catphish/ev-charge-controller/README

Charge Controller
=================

This controller has connectivity for CAN and EVSE as well as 4 x 12V digital inputs and 4 x low side switches.
