catphish/ev-charge-controller/hardware/charge-controller.pdf

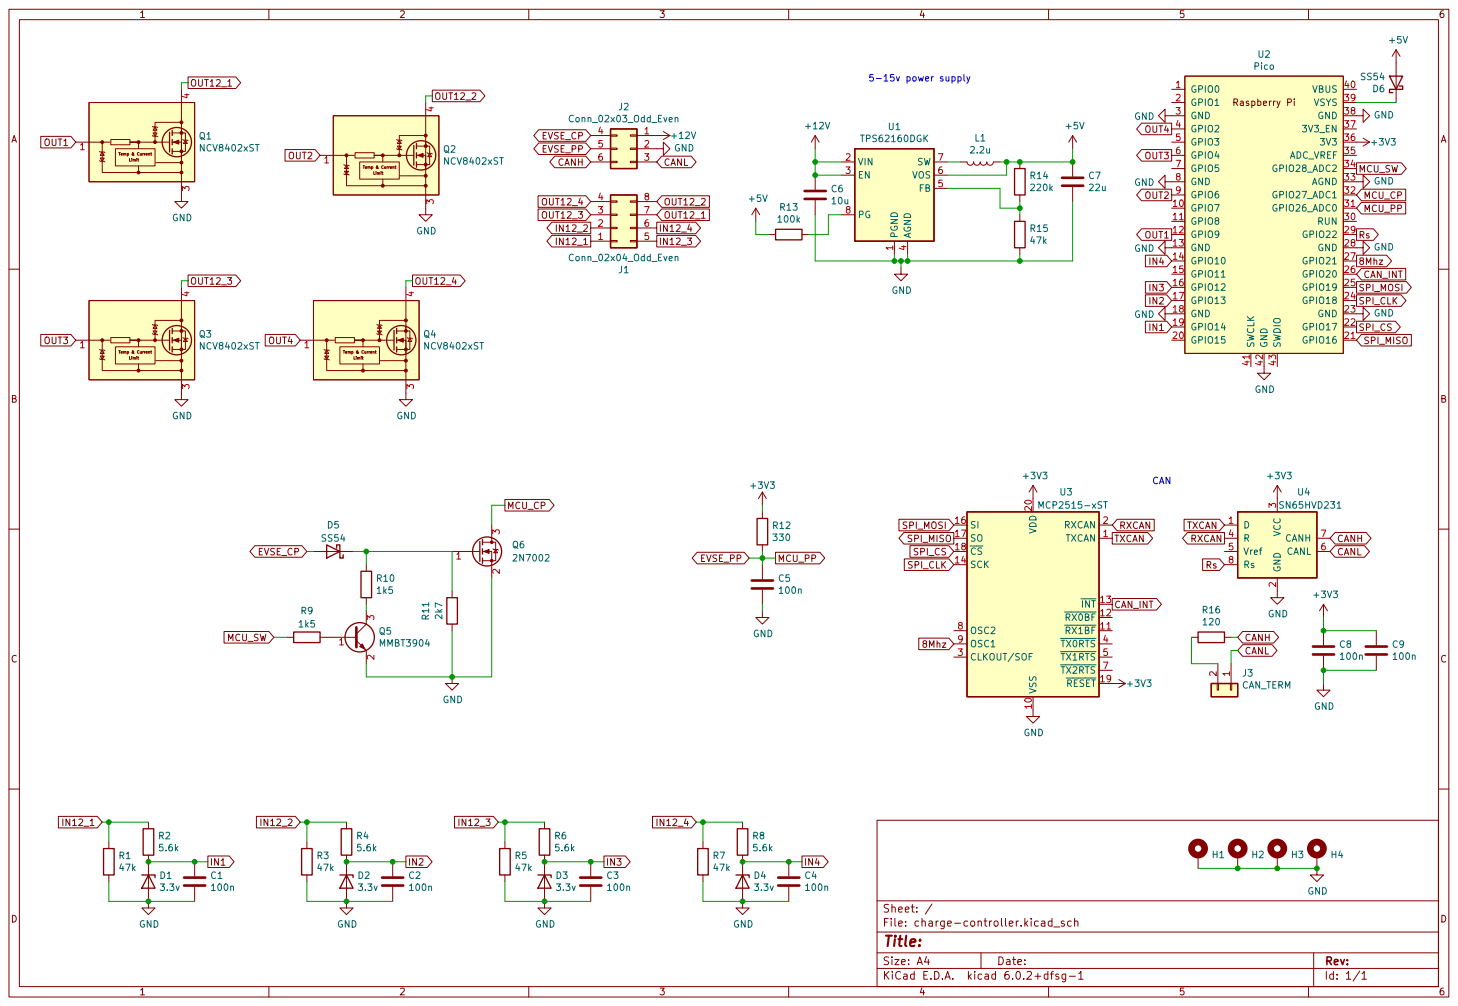
[picture p1: page 1]

4 FB 5 VOS 6 SW 7 PG 8 U1 TPS62160DGK

File: charge-controller.kicad_sch Sheet: /
Id: 1/1 Title:
