catphish/ev-charge-controller/hardware/charge-controller.kicad_pcb

## KiCad design hardware/charge-controller.kicad_pcb (2022-09-21)

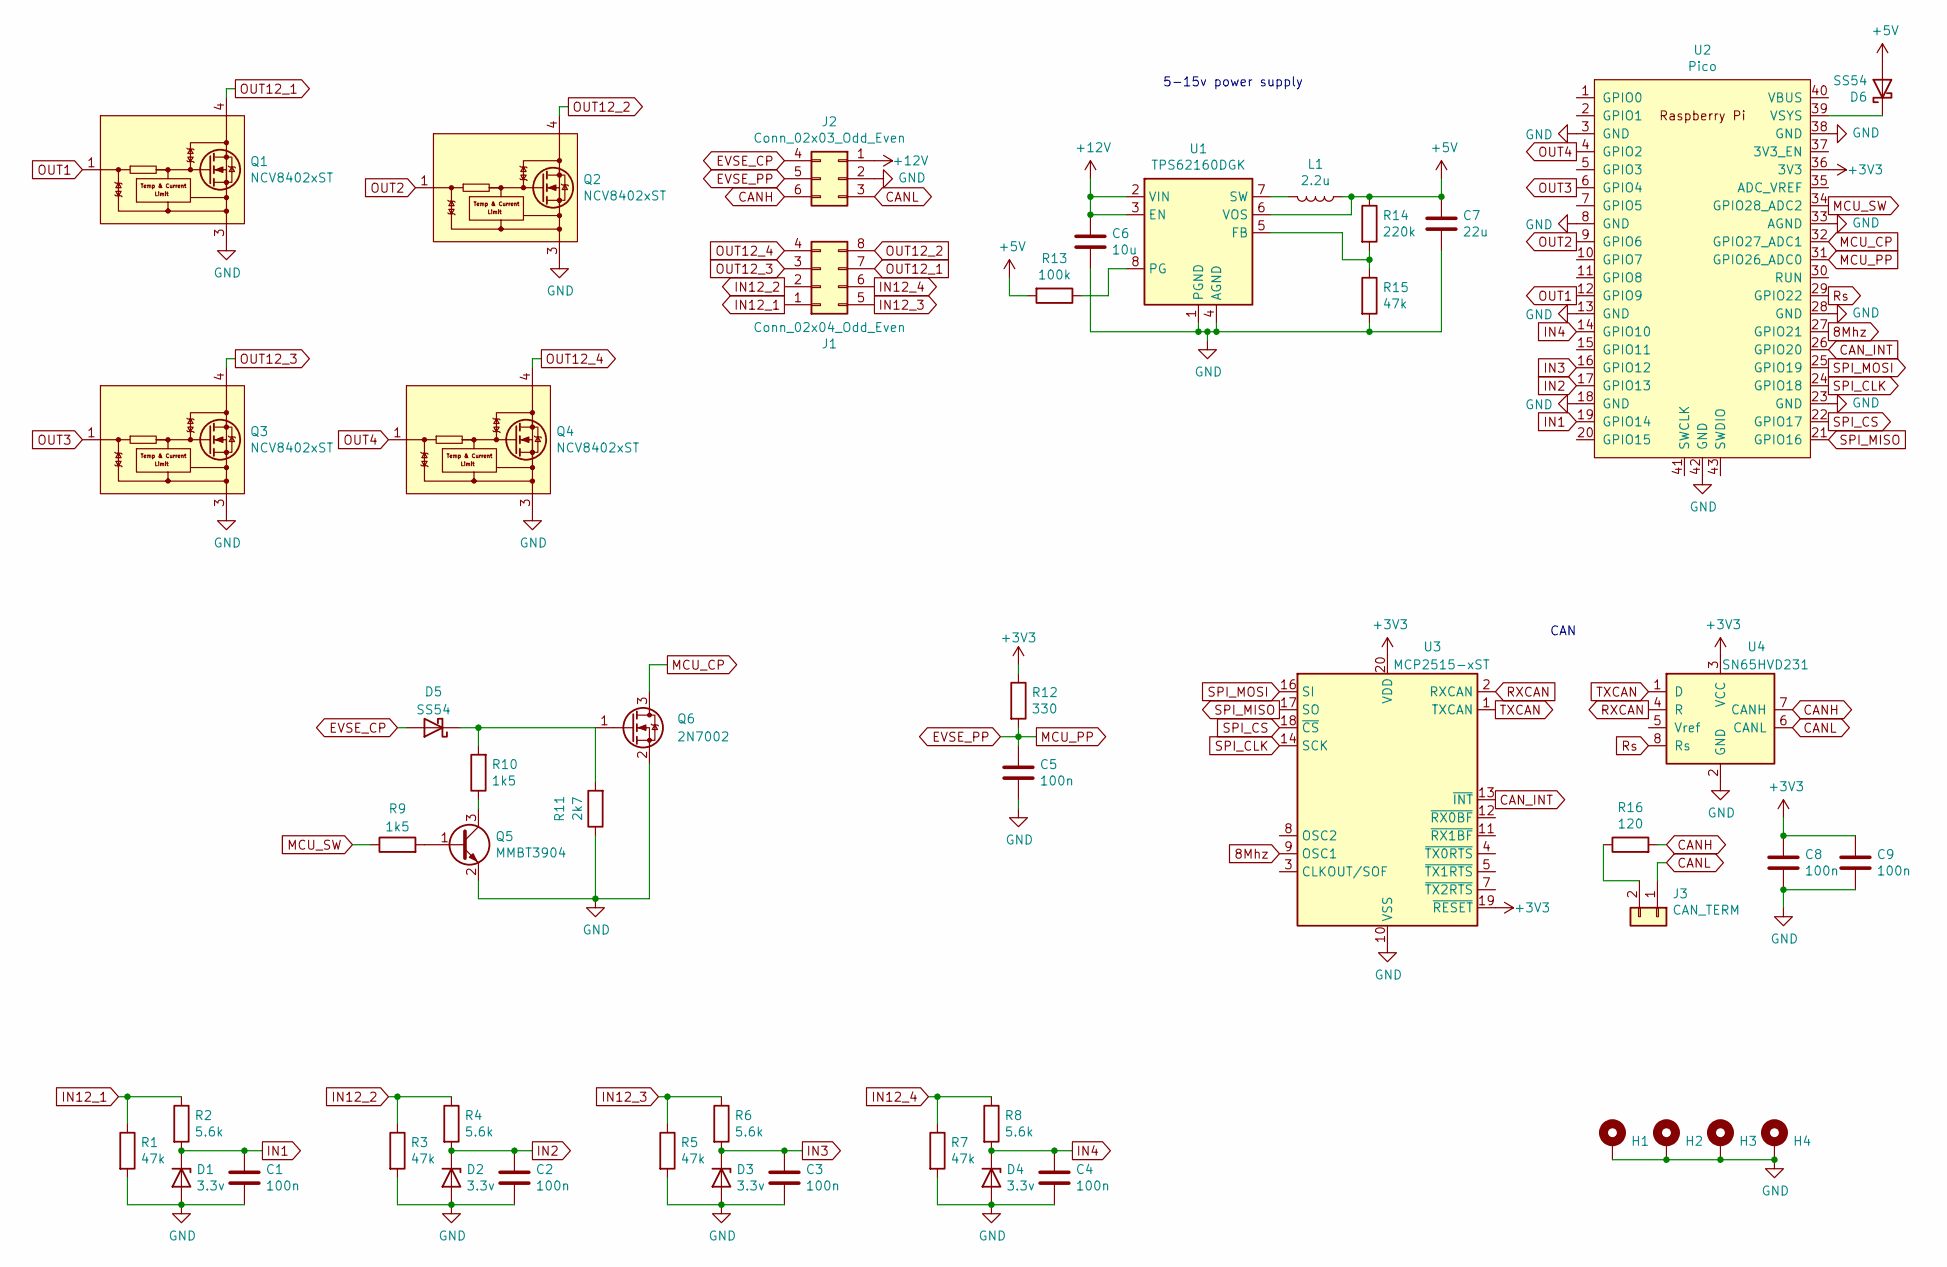
[picture p2: schematic charge-controller.kicad_sch]

Parts:
C1, C2, C3, C4, C5, C8, C9: 100n; C_0603_1608Metric; LCSC C14663
C6: 10u; C_1210_3225Metric; LCSC C77102
C7: 22u; C_1206_3216Metric; LCSC C5672
D1, D2, D3, D4: 3.3v; D_MiniMELF; LCSC C8056
D5, D6: SS54; D_SMA; LCSC C22452
H1, H2, H3, H4: MountingHole; MountingHole_3.2mm_M3_Pad
J1: Conn_02x04_Odd_Even; Molex_Micro-Fit_3.0_43045-0800_2x04_P3.00mm_Horizontal
J2: Conn_02x03_Odd_Even; Molex_Micro-Fit_3.0_43045-0600_2x03_P3.00mm_Horizontal
J3: CAN_TERM; PinHeader_1x02_P2.54mm_Vertical
L1: 2.2u; L_Neosid_SMS-ME3015; LCSC C43389
Q1, Q2, Q3, Q4: NCV8402xST; SOT-223; LCSC C77755
Q5: MMBT3904; SOT-23; LCSC C20526
Q6: 2N7002; SOT-23; LCSC C8545
R1, R3, R5, R7, R15: 47k; R_0603_1608Metric; LCSC C25819
R2, R4, R6, R8: 5.6k; R_0603_1608Metric; LCSC C23189
R9, R10: 1k5; R_0603_1608Metric; LCSC C22843
R11: 2k7; R_0603_1608Metric; LCSC C13167
R12: 330; R_0603_1608Metric; LCSC C23138
R13: 100k; R_0603_1608Metric; LCSC C25803
R14: 220k; R_0603_1608Metric; LCSC C22961
R16: 120; R_1206_3216Metric; LCSC C17909
U1: TPS62160DGK; MSOP-8_3x3mm_P0.65mm; LCSC C60726
U2: Pico; RPi_Pico_SMD_TH
U3: MCP2515-xST; TSSOP-20_4.4x6.5mm_P0.65mm; LCSC C15193
U4: SN65HVD231; SOIC-8_3.9x4.9mm_P1.27mm; LCSC C129257

Connections:
8Mhz: U2.27 (GPIO21), U3.9 (OSC1)
+3V3: C8.1, C9.1, R12.1, U2.36 (3V3), U3.19 (~RESET), U3.20 (VDD), U4.3 (VCC)
+5V: C7.1, D6.2 (A), L1.1, R13.2, R14.1, U1.6 (VOS)
+12V: C6.1, J2.1, U1.2 (VIN), U1.3 (EN)
CANH: J2.6, R16.2, U4.7 (CANH)
CANL: J2.3, J3.1, U4.6 (CANL)
CAN_INT: U2.26 (GPIO20), U3.13 (~INT)
EVSE_CP: D5.2 (A), J2.4
EVSE_PP: C5.1, J2.5, R12.2, U2.31 (GPIO26_ADC0)
GND: C1.2, C2.2, C3.2, C4.2, C5.2, C6.2, C7.2, C8.2, C9.2, D1.2 (A), D2.2 (A), D3.2 (A), D4.2 (A), H1.1, H2.1, H3.1, H4.1, J2.2, Q1.3 (S), Q2.3 (S), Q3.3 (S), Q4.3 (S), Q5.2 (E), Q6.2 (S), R1.2, R3.2, R5.2, R7.2, R11.1, R15.2, U1.1 (PGND), U1.4 (AGND), U2.3 (GND), U2.8 (GND), U2.13 (GND), U2.18 (GND), U2.23 (GND), U2.28 (GND), U2.33 (AGND), U2.38 (GND), U2.42 (GND), U3.10 (VSS), U4.2 (GND)
IN1: C1.1, D1.1 (K), R2.2, U2.19 (GPIO14)
IN2: C2.1, D2.1 (K), R4.2, U2.17 (GPIO13)
IN3: C3.1, D3.1 (K), R6.2, U2.16 (GPIO12)
IN4: C4.1, D4.1 (K), R8.2, U2.14 (GPIO10)
IN12_1: J1.1, R1.1, R2.1
IN12_2: J1.2, R3.1, R4.1
IN12_3: J1.5, R5.1, R6.1
IN12_4: J1.6, R7.1, R8.1
MCU_CP: Q6.3 (D), U2.32 (GPIO27_ADC1)
MCU_SW: R9.1, U2.34 (GPIO28_ADC2)
unnamed: D5.1 (K), Q6.1 (G), R10.2, R11.2
unnamed: D6.1 (K), U2.39 (VSYS)
unnamed: J3.2, R16.1
unnamed: L1.2, U1.7 (SW)
unnamed: Q5.1 (B), R9.2
unnamed: Q5.3 (C), R10.1
unnamed: R13.1, U1.8 (PG)
unnamed: R14.2, R15.1, U1.5 (FB)
OUT1: Q1.1 (G), U2.12 (GPIO9)
OUT2: Q2.1 (G), U2.9 (GPIO6)
OUT3: Q3.1 (G), U2.6 (GPIO4)
OUT4: Q4.1 (G), U2.4 (GPIO2)
OUT12_1: J1.7, Q1.2 (D), Q1.4 (D)
OUT12_2: J1.8, Q2.2 (D), Q2.4 (D)
OUT12_3: J1.3, Q3.2 (D), Q3.4 (D)
OUT12_4: J1.4, Q4.2 (D), Q4.4 (D)
RXCAN: U3.2 (RXCAN), U4.4 (R)
Rs: U2.29 (GPIO22), U4.8 (Rs)
SPI_CLK: U2.24 (GPIO18), U3.14 (SCK)
SPI_CS: U2.22 (GPIO17), U3.18 (~CS)
SPI_MISO: U2.21 (GPIO16), U3.17 (SO)
SPI_MOSI: U2.25 (GPIO19), U3.16 (SI)
TXCAN: U3.1 (TXCAN), U4.1 (D)

Notes on the sheet:
CAN
5-15v power supply

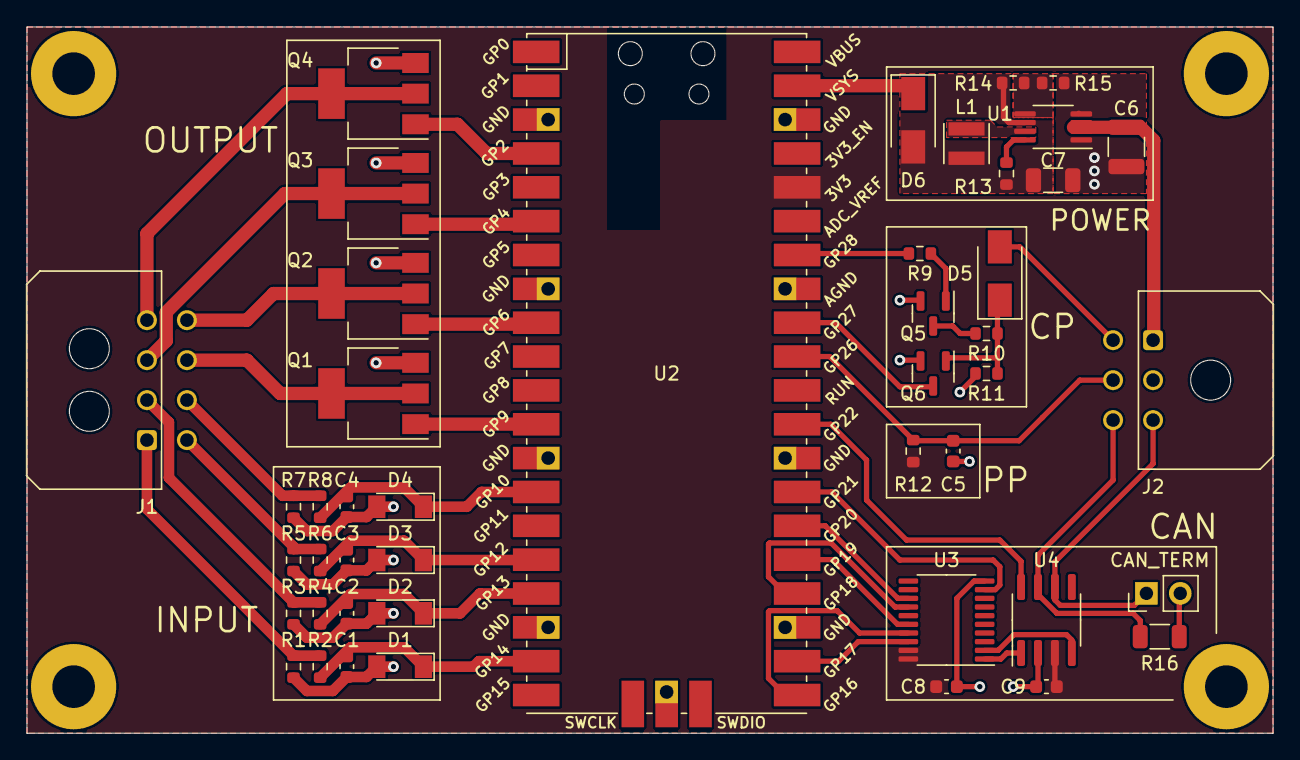
[picture p3: board charge-controller.kicad_pcb from above]

Board: 2 copper layers, 93.5 x 53.0 mm, 49 parts (0 on the bottom side), 43 nets.
