catphish/ev-charge-controller/(commit log)

2021-12-24 tidy up traces
    [charge-controller.kicad_pcb]
2021-12-24 add logo
    [charge-controller.kicad_pcb]
2022-01-08 improve 12v inputs, connect CAN line driver sleep pin
    [charge-controller.kicad_pcb, charge-controller.sch]
2022-01-10 update schematic and picture
    [charge-controller.kicad_pcb, charge-controller.sch]
2022-01-12 rework inuts
    [charge-controller.kicad_pcb, charge-controller.sch]
2022-01-13 finish inputs
    [charge-controller.kicad_pcb, charge-controller.sch]
2022-01-30 begin EVSE comms
    [charge-controller.sch]
2022-05-20 major work on charging, EVSE comms, BMS comms
2022-05-21 low power sleep
2022-05-22 charger CAN output
2022-05-22 CAN fixes and improvements
    [charge_controller.c]
2022-06-01 tidying, add under temperature protection, configure GPIO for Datsun test
2022-06-01 replace static USB mode with dynamic USB detection
    [charge_controller.c]
2022-07-14 low voltage cutoff for heater, stop charging at 4.0V
2022-08-03 remove interrupts, for reasons i can't be bothered to understand, sometimes they get stuck in a loop
    [charge_controller.c]
2022-09-21 hardware fix for CP line
    [charge-controller.kicad_pcb, charge-controller.kicad_sch]
2023-02-16 reduce charge temperature limit
2023-03-22 fix small register typo
    [charge_controller.c]
2025-06-02 Add timer include which now seems to be required to use sleep
